jeremy-daily/TeensyCrashDAQ/(list of files, drawings)

Other design files:
Hardware and Schematics/Altium Files/CrashDAQ For Hammond 1554H.PcbDoc
Hardware and Schematics/Altium Files/CrashDAQSensors.SchDoc
Hardware and Schematics/Altium Files/TeensyCrashDAQ.PrjPcb
Hardware and Schematics/Altium Files/TeensyCrashDAQ.SchDoc
