jeremy-daily/TeensyCrashDAQ/Arduino Sketches/AnalogDataloggerWithXandY/AnalogDataloggerWithXandY.ino

/*
  SD card datalogger
 
 This example shows how to log data from three analog sensors 
 to an SD card using the SD library.
 	
 The circuit:
 * analog sensors on analog ins 0, 1, and 2
 * SD card attached to SPI bus as follows:
 ** MOSI - pin 11
 ** MISO - pin 12
 ** CLK - pin 13
 ** CS - pin 4
 
 created  24 Nov 2010
 modified 9 Apr 2012
 by Tom Igoe
 
 This example code is in the public domain.
 	 
 */

#include <SD.h>
#include <SPI.h>

// On the Ethernet Shield, CS is pin 4. Note that even if it's not
// used as the CS pin, the hardware CS pin (10 on most Arduino boards,
// 53 on the Mega) must be left as an output or the SD library
// functions will not work.

// change this to match your SD shield or module;
// Arduino Ethernet shield: pin 4
// Adafruit SD shields and modules: pin 10
// Sparkfun SD shield: pin 8
// Teensy audio board: pin 10
// Wiz820+SD board: pin 4
// Teensy 2.0: pin 0
// Teensy++ 2.0: pin 20
const int chipSelect = A1;

float Xoffset = 0.0;
float Xgain = 1.0;

float Yoffset = 0.0;
float Ygain = 1.0;

uint32_t currentMicros = 0;

String dataString = "abcdefghijklmnopqrstuvwxyz";
  
void setup()
{
 // Open serial communications and wait for port to open:
  Serial.begin(9600);
   while (!Serial) {
    ; // wait for serial port to connect. Needed for Leonardo only
  }


  Serial.print("Initializing SD card...");
  
  // see if the card is present and can be initialized:
  if (!SD.begin(chipSelect)) {
    Serial.println("Card failed, or not present");
    // don't do anything more:
    return;
  }
  Serial.println("card initialized.");
}

void loop()
{
  currentMicros = micros();
  // make a string for assembling the data to log:
  
  dataString = String(currentMicros);
  dataString += ",";
  
  // read three sensors and append to the string:
  int Xsensor = analogRead(A10);
  int Ysensor = analogRead(A11);
  dataString += String((Xsensor-Xoffset)*Xgain);
  dataString += ",";
  dataString += String((Ysensor-Yoffset)*Ygain);
  dataString += "\n";

  // open the file. note that only one file can be open at a time,
  // so you have to close this one before opening another.
  File dataFile = SD.open("high-G.csv", FILE_WRITE);

  // if the file is available, write to it:
  if (dataFile) {
    dataFile.println(dataString);
    dataFile.close();
    // print to the serial port too:
    Serial.println(dataString);
  }  
  // if the file isn't open, pop up an error:
  else {
    Serial.println("error opening datalog.txt");
  } 
}
