jeremy-daily/TeensyCrashDAQ/(commit log)

2016-04-11 Initial Commit with PCB halfway finished
    [CrashDAQ For Hammond 1554B.PcbDoc, CrashDAQ For Hammond 1554H.PcbDoc, CrashDAQSensors.SchDoc, TeensyCrashDAQ.PrjPcb, TeensyCrashDAQ.SchDoc]
2016-04-15 Added Some Parts
    [CrashDAQ For Hammond 1554H.PcbDoc, CrashDAQSensors.SchDoc, TeensyCrashDAQ.SchDoc]
2016-04-17 Cleaned Directory and Posted HW Designs
    Directory is ready for code
    [Bill Of Materials for TeensyCrashDAQ - SMT Only.csv, CrashDAQ For Hammond 1554B.PcbDoc, CrashDAQ For Hammond 1554H.PcbDoc, CrashDAQSensors.SchDoc, TeensyCrashDAQ.PrjPcb, TeensyCrashDAQ.SchDoc]
2016-04-24 Initial Sketches for Arduino Progamming
    SD Proof of circuit
    ADC attempts
2016-04-25 GPS Logger with SD and Time Sync
    Arduino sketch using TinyGPS that can log GPS data at 10Hz only on
    motion.
2016-04-25 Fixed SD card access issue
    Added High outputs for all the SPI chip select pins in the startup loop.
    [ReadSDdatafromLongFileNames.ino, SetTimeFromGPSonStartup.ino]
2016-04-30 5000 Hz Analog Sensors
    Added low latency logger to repository. Will use for crash test.
    [HighGLowLatencyLogger.ino, UserDataType.h]
2016-04-30 True 5000 Hz sampling
2016-04-30 Took out Serial for crash testing
    [HighGLowLatencyLogger.ino]
